CristianVoina/LCDI2C_PentruPreteni/Documentatie/Utilizare MQ135.docx

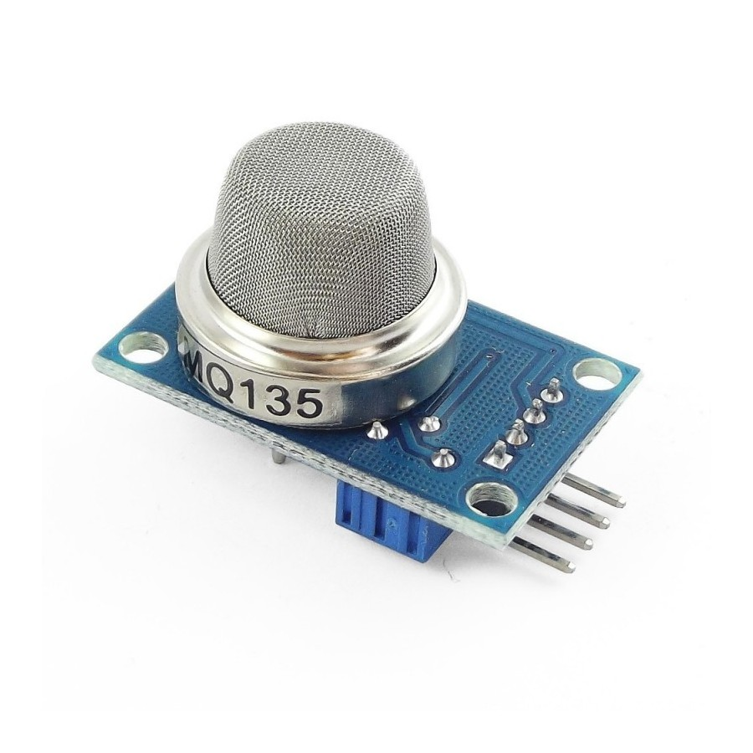
[picture p1: figure]

# Utilizare MQ135

MQ-135 este un senzor care poate sa masoare NH3,NOx, alcohol, Benzene, smoke,CO2 ,etc.. Poate sa fie folosit in uz casnic sau industrial.

ATENTIE! Senzorul trebuie calibrat si nu este recomandat sa fie folosit fara calibrare.

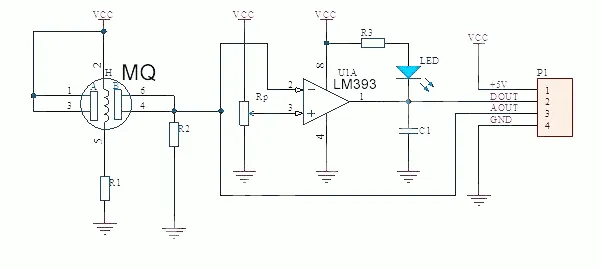
[picture p2: figure]

Fig.1 - Schematic

ATENTIE! Acest senzor are nevoie de ~350mW putere pentru incalzire. In cazul in care folositi Arduino, sa nu alimentati de la un pin. Folositi pinul care vine de pe regulatorul de tensiune sau o sursa externa.

DOUT -> se leaga la un pin de intrare digital (cand pragul setat de potentiometru este depasit va trece in HIGH) (Nu recomand folosirea acestui pin)

AOUT -> se leaga la o intrare analogica, aici vom masura PPM (in urmatorul exemplu voi folosi un ADC pe 10bit)

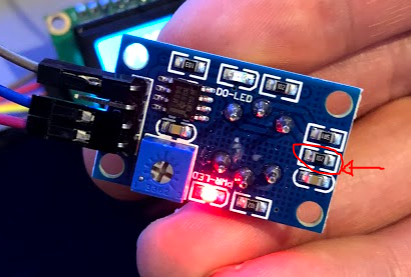
[picture p3: figure]

Principiul de functionare

Intre pinii 1,3 si 4,6 ai MQ-ului (fig.1) se formeaza o rezistenta care inseriata cu R2 (10k sau se poate masura pe placa senzorului) va forma un divizor de tensiune. In functie de calitatea aerului rezistenta MQ-ului se va modifica si in consecinta va modifica tensiunea masurata la AOUT.

Calcul PPM

In imaginea alaturata, extrasa din datasheet (https://www.tme.eu/Document/2578fa81c261e398e9967a2f575c3ebe/MQ135.pdf), putem sa alegem gaz-ul pentru care dorim sa masuram.

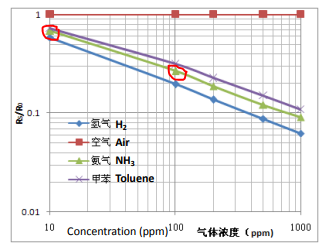
[picture p4: figure]

ATENTIE! Graficul este de tip log-log (https://en.wikipedia.org/wiki/Log%E2%80%93log_plot).

In cazul meu am ales sa fac pentru NH3. Cele 2 puncte incercuite cu rosu formeaza o dreapta si vom face calculul pentru dreapta de mai jos. Defapt nu este o dreapta ci o curba, dar putem sa aplicam formula dreptei cu exceptia ca este logaritmic.

log(y)=m*log(x)+log(b)

Unde avem y = Rs/Ro si x=ppm. Rs este rezistenta masurata la un anumit timp si Ro este rezistenta in “aer curat”. Fig. 2 - Grafic din datasheet

ATENTIE! Toate valorile sunt cu aproximatie. (Cat am reusit sa deduc din grafic)

Pentru calcularea ppm vom avea urmatoarea formula: log(x)=(log(y)-log(b))/m . De aici avem nevoie de b (intercept) si m (slope).

Pentru panta (slope) vom avea urmatoarea formula: m=(Δlog(y))/(Δlog(x)) care poate sa fie extinsa la m=(log(y2)-log(y1))/(log(x2)-log(x1)) . Pentru cazul nostru m=(log(0.2)-log(0.7))/(log(100)-log(10)) . Rezulta o panta negativa de -0.8529.

Pentru a obtine log(b) trebuie sa luam un x si y cunoscut si sa le adaugam in ecuatie. Vezi ecuatie mai jos.

log(0.7)=[-0.8529*log(10)]+log(b)

Rezolvarea pentru b va ajunge sa fie b=4.9888 .

Pentru a obtine Ro trebuie pornit senzorul timp de 24h si apoi pot incepe masuratorile.

In cazul meu am primit un rezultat pe ADC de 60. Pentru a transforma in tensiune trebuie folosita urmatoarea formula: V_a =(5*ADC)/1023 unde ADC este valoarea citita si V_a este tensiunea.

Aici vom folosi formula divizorului (https://en.wikipedia.org/wiki/Voltage_divider) de tensiune pentu a obtine valoarea Ro si ajungem la urmatoarea formula: Ro=(R2(Vs-V_a ))/(V_a) . Unde Vs este tensiunea de alimentare a senzorului si Va este masurata la intrarea ADC. Aceasi formula poate fi folosita si mai tarziu pentru calcularea lui Rs. Vom avea un Ro=160500 .

Acum avem toate datele necesare ca sa putem sa facem un calcul de validare. Vom lua o coordonata y din fig. 2, y=2. Pentru asta vom avea urmatoarea formula:

log(x)=(log(0.7)-log(4.9888))/(-0.8529) (vezi formula mai sus)

x=10^(((-0.8528)/(-0.8529))) vom avea un x=9.9973

Cu formula de mai sus am demonstrat ca suntem relativ aproape de valoarea dorita. Voiam sa dovedesc ca ajungem la 10 ppm.

Formula finala va fi: PPM=10^(((log((Rs)/(Ro))-log(b))/m))

Code

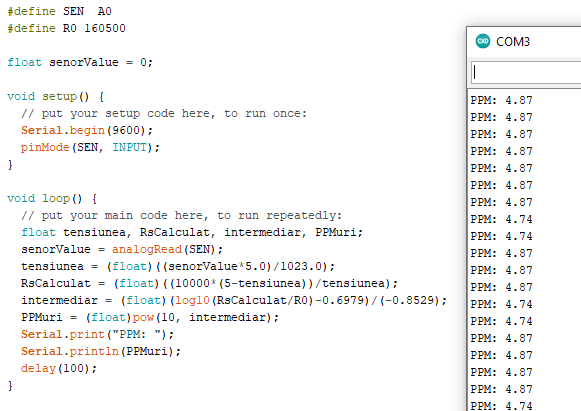
[picture p5: figure]
