CristianVoina/LCDI2C_PentruPreteni/EagleFiles/TheSchematic.brd

## EAGLE design EagleFiles/TheSchematic.brd (2021-02-09)

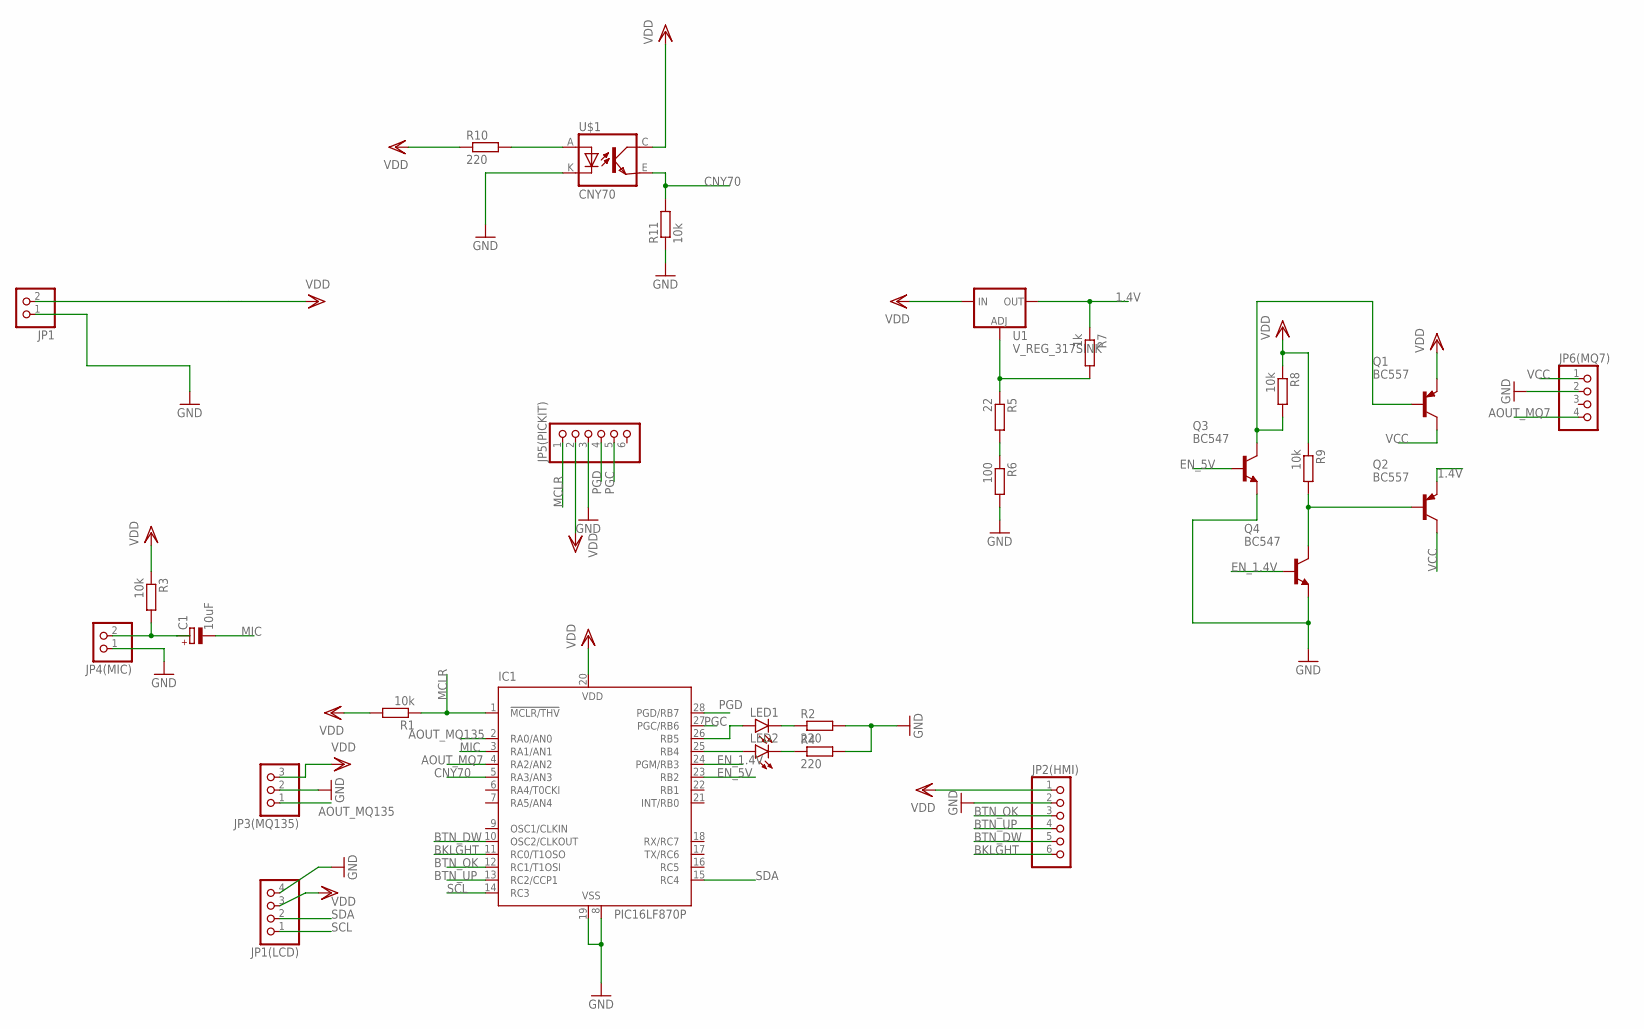
[picture p11: schematic TheSchematic.sch]

Parts:
C1: 10uF; E1,8-4
IC1: PIC16LF870P; DIL28-3
JP1, JP4(MIC): PINHD-1X2; 1X02
JP1(LCD), JP6(MQ7): PINHD-1X4; 1X04
JP2(HMI), JP5(PICKIT): PINHD-1X6; 1X06
JP3(MQ135): PINHD-1X3; 1X03
LED1, LED2: LED5MM
Q1, Q2: BC557; TO92-EBC
Q3, Q4: BC547; TO92
R1, R3, R8, R9: 10k; 0204/7
R2, R4, R10: 220; 0207/10
R5: 22; 0204/7
R6: 100; 0204/7
R7: 1k; 0204/7
R11: 10k; 0207/10
U1: V_REG_317SINK; TO220-ADJ
U$1: CNY70; 4

Connections:
1.4V: Q2.E, R7.1, U1.OUT
AOUT_MQ7: IC1.4 (RA2/AN2), JP6(MQ7).4
AOUT_MQ135: IC1.2 (RA0/AN0), JP3(MQ135).1
BKLGHT: IC1.11 (RC0/T1OSO), JP2(HMI).6
BTN_DW: IC1.10 (OSC2/CLKOUT), JP2(HMI).5
BTN_OK: IC1.12 (RC1/T1OSI), JP2(HMI).3
BTN_UP: IC1.13 (RC2/CCP1), JP2(HMI).4
CNY70: IC1.5 (RA3/AN3), R11.2, U$1.E (EMI)
EN_1.4V: IC1.24 (PGM/RB3), Q4.2 (B)
EN_5V: IC1.23 (RB2), Q3.2 (B)
GND: IC1.8 (VSS), IC1.19 (VSS), JP1.1, JP1(LCD).4, JP2(HMI).2, JP3(MQ135).2, JP4(MIC).1, JP5(PICKIT).3, JP6(MQ7).2, Q3.1 (E), Q4.1 (E), R2.2, R4.2, R6.2, R11.1, U$1.K (C)
MCLR: IC1.1 (!MCLR/THV), JP5(PICKIT).1, R1.1
MIC: C1.-, IC1.3 (RA1/AN1)
unnamed: R5.1, R7.2, U1.ADJ
unnamed: IC1.26 (RB5), LED1.A
unnamed: LED1.K (C), R2.1
unnamed: C1.+, JP4(MIC).2, R3.2
unnamed: IC1.25 (RB4), LED2.A
unnamed: LED2.K (C), R4.1
unnamed: R5.2, R6.1
unnamed: R10.2, U$1.A
unnamed: Q1.B, Q3.3 (C), R8.2
unnamed: Q2.B, Q4.3 (C), R9.2
PGC: IC1.27 (PGC/RB6), JP5(PICKIT).5
PGD: IC1.28 (PGD/RB7), JP5(PICKIT).4
SCL: IC1.14 (RC3), JP1(LCD).1
SDA: IC1.15 (RC4), JP1(LCD).2
VCC: JP6(MQ7).1, Q1.C, Q2.C
VDD: IC1.20 (VDD), JP1.2, JP1(LCD).3, JP2(HMI).1, JP3(MQ135).3, JP5(PICKIT).2, Q1.E, R1.2, R3.1, R8.1, R9.1, R10.1, U1.IN, U$1.C (COL)

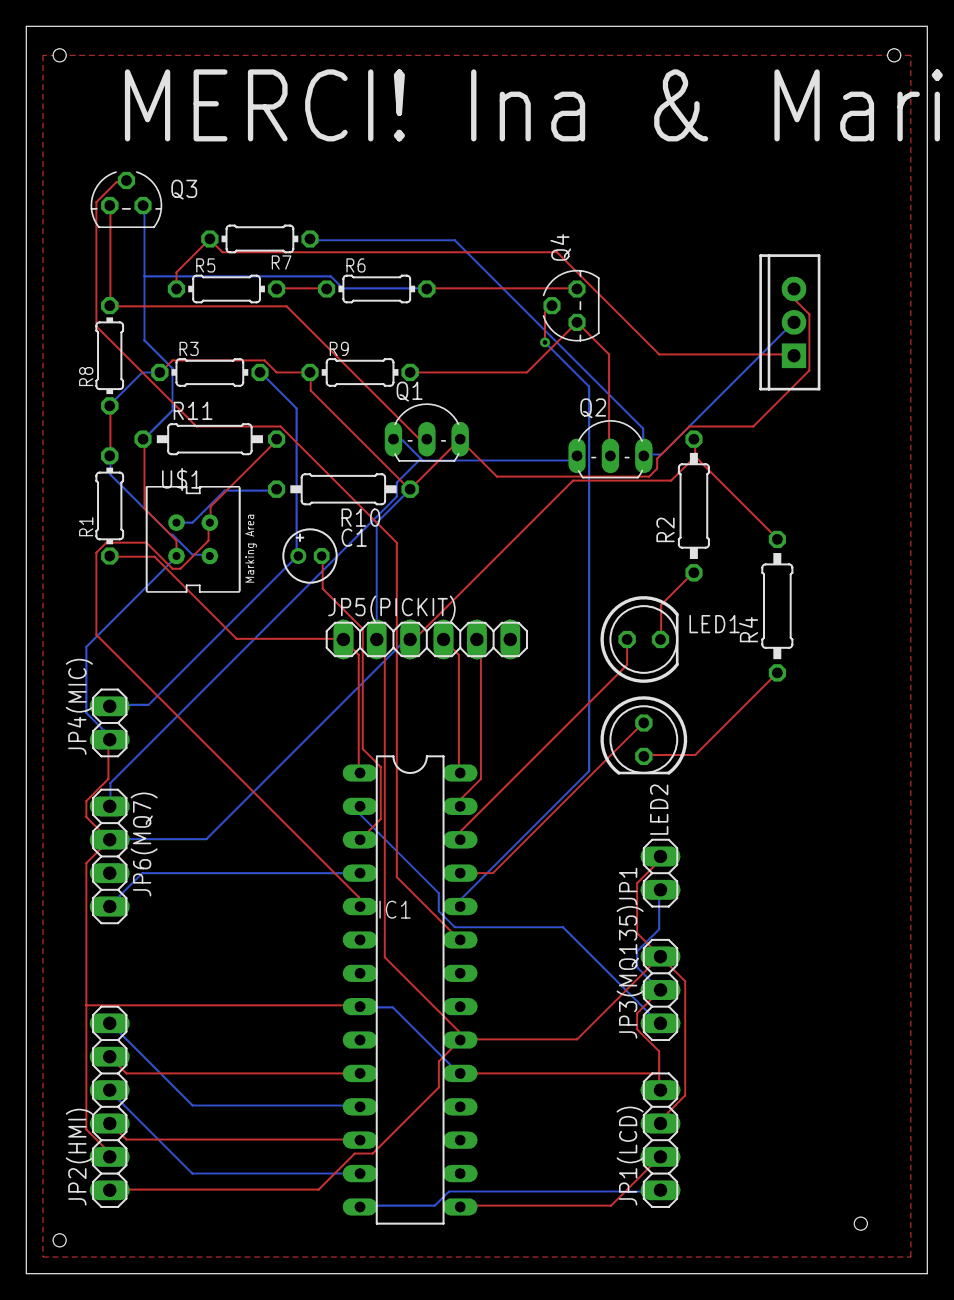
[picture p12: board TheSchematic.brd from above]

Board: 2 copper layers, 68.6 x 94.9 mm, 28 parts (0 on the bottom side), 29 nets.
