CristianVoina/LCDI2C_PentruPreteni/LCD.h

/* Microchip Technology Inc. and its subsidiaries.  You may use this software 
 * and any derivatives exclusively with Microchip products. 
 * 
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
 * IN NO EVENT WILL MICROCHIP BE LIABLE FOR ANY INDIRECT, SPECIAL, PUNITIVE, 
 * INCIDENTAL OR CONSEQUENTIAL LOSS, DAMAGE, COST OR EXPENSE OF ANY KIND 
 * WHATSOEVER RELATED TO THE SOFTWARE, HOWEVER CAUSED, EVEN IF MICROCHIP HAS 
 * BEEN ADVISED OF THE POSSIBILITY OR THE DAMAGES ARE FORESEEABLE.  TO THE 
 * FULLEST EXTENT ALLOWED BY LAW, MICROCHIP'S TOTAL LIABILITY ON ALL CLAIMS 
 * IN ANY WAY RELATED TO THIS SOFTWARE WILL NOT EXCEED THE AMOUNT OF FEES, IF 
 * ANY, THAT YOU HAVE PAID DIRECTLY TO MICROCHIP FOR THIS SOFTWARE.
 *
 * MICROCHIP PROVIDES THIS SOFTWARE CONDITIONALLY UPON YOUR ACCEPTANCE OF THESE 
 * TERMS. 
 */

/* 
 * File:   
 * Author: 
 * Comments:
 * Revision history: 
 */

// This is a guard condition so that contents of this file are not included
// more than once.  
#ifndef XC_HEADER_TEMPLATE_H
#define	XC_HEADER_TEMPLATE_H

#include <xc.h> // include processor files - each processor file is guarded. 
#include "mcc_generated_files/mcc.h"

#pragma warning disable 520

#include <stdint.h>
#include "mcc_generated_files/i2c1.h"

// TODO Insert appropriate #include <>

// TODO Insert C++ class definitions if appropriate

// TODO Insert declarations

// Comment a function and leverage automatic documentation with slash star star
/**
    <p><b>Function prototype:</b></p>
  
    <p><b>Summary:</b></p>

    <p><b>Description:</b></p>

    <p><b>Precondition:</b></p>

    <p><b>Parameters:</b></p>

    <p><b>Returns:</b></p>

    <p><b>Example:</b></p>
    <code>
 
    </code>

    <p><b>Remarks:</b></p>
 */
// TODO Insert declarations or function prototypes (right here) to leverage 
// live documentation

#ifdef	__cplusplus
extern "C" {
#endif /* __cplusplus */

    // TODO If C++ is being used, regular C code needs function names to have C 
    // linkage so the functions can be used by the c code. 

#ifdef	__cplusplus
}
#endif /* __cplusplus */

#define LCD_FIRST_ROW          0x80
#define LCD_SECOND_ROW         0xC0
#define LCD_THIRD_ROW          0x94
#define LCD_FOURTH_ROW         0xD4
#define LCD_CLEAR              0x01
#define LCD_RETURN_HOME        0x02
#define LCD_ENTRY_MODE_SET     0x04
#define LCD_CURSOR_OFF         0x0C
#define LCD_UNDERLINE_ON       0x0E
#define LCD_BLINK_CURSOR_ON    0x0F
#define LCD_MOVE_CURSOR_LEFT   0x10
#define LCD_MOVE_CURSOR_RIGHT  0x14
#define LCD_TURN_ON            0x0C
#define LCD_TURN_OFF           0x08
#define LCD_SHIFT_LEFT         0x18
#define LCD_SHIFT_RIGHT        0x1E
#define LCD_BACKLIGHT          0x08
#define LCD_NOBACKLIGHT        0x00

#ifndef LCD_TYPE
   #define LCD_TYPE 2           // 0=5x7, 1=5x10, 2=2 lines
#endif

void I2C_Write(uint8_t i2c_data);
void LCD_Write_Nibble(uint8_t n);
void LCD_Cmd(uint8_t Command);
void LCD_Goto(uint8_t col, uint8_t row);
void LCD_PutC(char LCD_Char);
void LCD_Print(char* LCD_Str);
void LCD_Begin(uint8_t _i2c_addr);
void Backlight(void);
void noBacklight(void);
uint8_t getBacklight(void);

#endif	/* XC_HEADER_TEMPLATE_H */
