CristianVoina/LCDI2C_PentruPreteni/LCD.c

#include "LCD.h"

__bit RS;
uint8_t i2c_addr, backlight_val = LCD_BACKLIGHT;

/********************** I2C functions **************************/

void I2C_Write(uint8_t i2c_data)
{
    I2C1_MESSAGE_STATUS status = I2C1_MESSAGE_PENDING;
    I2C1_MasterWrite(&i2c_data, 1, 0x27, &status);

    while(status == I2C1_MESSAGE_PENDING);
}

/********************** end I2C functions **********************/

void Expander_Write(uint8_t value)
{
  I2C_Write(value | backlight_val);
}

void LCD_Write_Nibble(uint8_t n)
{
  n |= RS;
  Expander_Write(n & 0xFB);
  __delay_us(1);
  Expander_Write(n | 0x04);
  __delay_us(1);
  Expander_Write(n & 0xFB);
  __delay_us(100);
}

void LCD_Cmd(uint8_t Command)
{
  RS = 0;
  LCD_Write_Nibble(Command & 0xF0);
  LCD_Write_Nibble((Command << 4) & 0xF0);
  if((Command == LCD_CLEAR) || (Command == LCD_RETURN_HOME))
    __delay_ms(2);
}

void LCD_Goto(uint8_t col, uint8_t row)
{
  switch(row)
  {
    case 2:
      LCD_Cmd(LCD_SECOND_ROW + col - 1);
      break;
    case 3:
      LCD_Cmd(LCD_THIRD_ROW  + col - 1);
      break;
    case 4:
      LCD_Cmd(LCD_FOURTH_ROW + col - 1);
    break;
    default:      // case 1:
      LCD_Cmd(LCD_FIRST_ROW  + col - 1);
  }

}

void LCD_PutC(char LCD_Char)
{
  RS = 1;
  LCD_Write_Nibble(LCD_Char & 0xF0);
  LCD_Write_Nibble((LCD_Char << 4) & 0xF0);
}

void LCD_Print(char* LCD_Str)
{
  uint8_t i = 0;
  RS = 1;
  while(LCD_Str[i] != '\0')
  {
    LCD_Write_Nibble(LCD_Str[i] & 0xF0);
    LCD_Write_Nibble( (LCD_Str[i++] << 4) & 0xF0 );
  }
}

void LCD_Begin(uint8_t _i2c_addr)
{
  i2c_addr = _i2c_addr;
  Expander_Write(0);

  __delay_ms(40);
  LCD_Cmd(3);
  __delay_ms(5);
  LCD_Cmd(3);
  __delay_ms(5);
  LCD_Cmd(3);
  __delay_ms(5);
  LCD_Cmd(LCD_RETURN_HOME);
  __delay_ms(5);
  LCD_Cmd(0x20 | (LCD_TYPE << 2));
  __delay_ms(50);
  LCD_Cmd(LCD_TURN_ON);
  __delay_ms(50);
  LCD_Cmd(LCD_CLEAR);
  __delay_ms(50);
  LCD_Cmd(LCD_ENTRY_MODE_SET | LCD_RETURN_HOME);
  __delay_ms(50);
}

void Backlight(void) 
{
  backlight_val = LCD_BACKLIGHT;
  //Expander_Write(0);
}

void noBacklight(void) 
{
  backlight_val = LCD_NOBACKLIGHT;
  //Expander_Write(0);
}

uint8_t getBacklight(void)
{
    return backlight_val;
}
